danenicol/PALMS/README.md

5e3fbf1b-5832-4e8d-8d21-c7ad76bd68b0 (2)

# PALMS
Passive Analog Localization via Multilateration System 被动式模拟多点定位系统

Designed by: Dane Nicol @SDSUMechatronics

## General Summary (English)
PALMS is a fully analog system that detects underwater acoustic pingers at five specific frequencies (20–40 kHz) and provides directional guidance for autonomous underwater vehicles (AUVs). At its core is a state variable filter (SVF) that enables precise, independent control of frequency and selectivity without any digital signal processing. The system prioritizes low latency, deterministic timing, and minimal digital control, making it ideal for real-time navigation in high-noise aquatic environments. This project is for SDSU Mechatronics' participation in Robo-Sub, from Robo-Nation: https://robosub.org/

## 总结（简体中文）
PALMS是一个全模拟系统，用于检测五个特定频率（20–40 kHz）的水下声学脉冲信号，并为自主水下航行器（AUV）提供方向引导。其核心是状态变量滤波器（SVF），无需任何数字信号处理即可独立控制频率和选择性。该系统以低延迟、确定性定时和最少的数字控制为优势，非常适合高噪声水下环境中的实时导航。 这项目为了SDSU Mechatronics’ 参加在Robo-Sub，从Robo-Nation: https://robosub.org/

## System Design || Theory || Simulation Results:
[Click here to view the full Documentation](<Documentation/PALMS System Design.pdf>)

## PCB Design
Iteration #2



Iteration #1
*Due to time constrains, design has been simplified to 2 dimensions, with TDOA signals being sent out to another computer. Analog TDOA computation circuit not included within Iteration #1
Screenshot_select-area_20260617214514
Screenshot_select-area_20260617214440

Older Design (Decommissioned)
Screenshot_select-area_20260927210900
Screenshot_select-area_20260927211105

## Application/Results in AUV
COMING SOON
