danenicol/PALMS/Documentation/PALMS System Design.pdf

# PALMS System Design

### Dane Nicol

Designed by Dane Nicol
@Mechatronics SDSU
March 3, 2026

## Block 1 (Voltage Buffer + SVF):

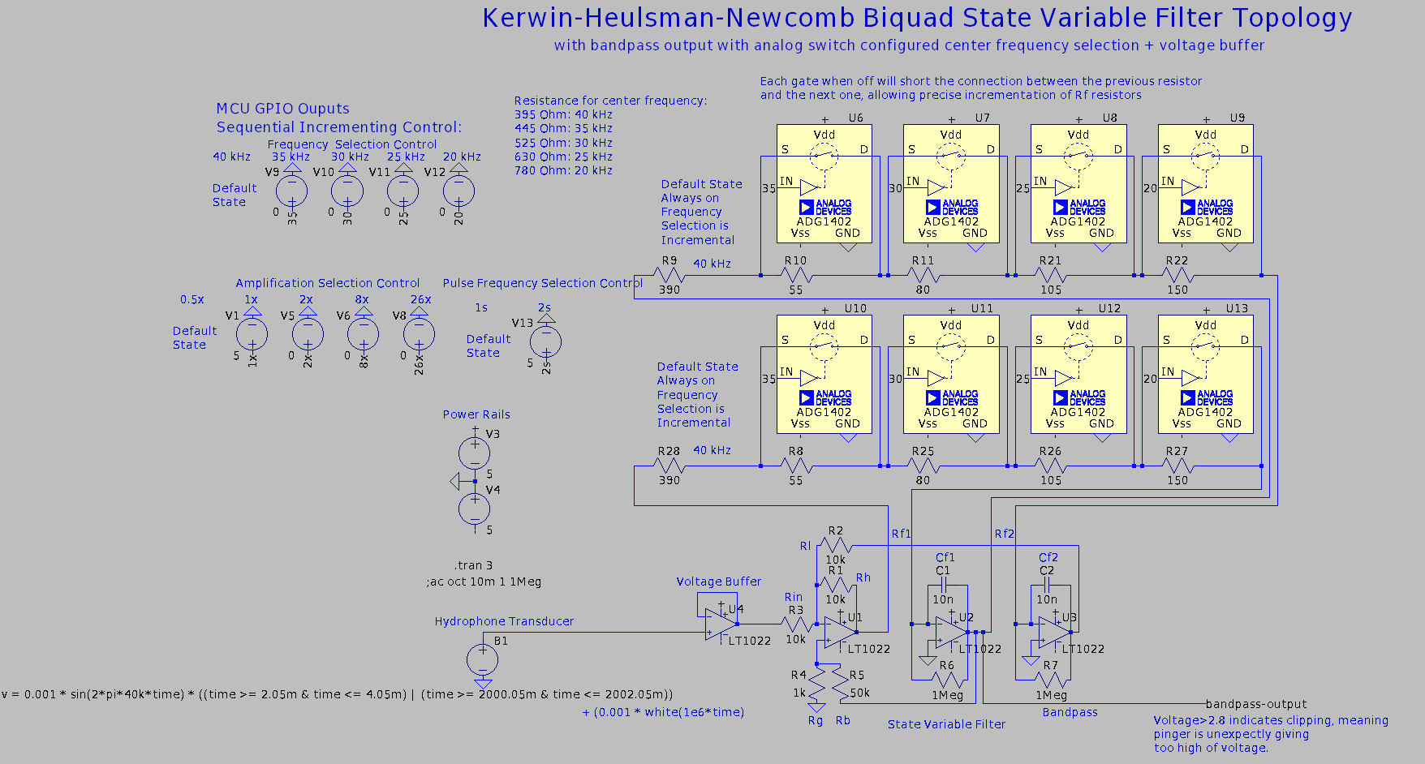
[picture p1: figure]

## Input Buffer Stage:

The hydrophone output is first routed into a voltage buffer. This state isolates the transducer from downstream loading effects, ensuring the best signal integrity and preserving amplitude fidelity. This uses the LT1022, with -/+ 5 V rails. Bandpass output is already low-impedance, no additional buffer needed.

Dane Nicol @SDSUMechantronics

## Analog Tunable State Variable Filter (SVF):

The buffered signal then feeds into the SVF, which is controlled via analog switches, that when off, short the series line of the resistors, bypassing what would be added resistance (that would decrease the selected frequency). The exact resistance was manually tested through many AC sweeps to determine that 395 Ω, 445 Ω, 525 Ω, 630 Ω, and 780 Ω all match the following frequencies 40 kHz, 35 kHz, 30 kHz, 25 kHz, and 20 kHz, respectively:

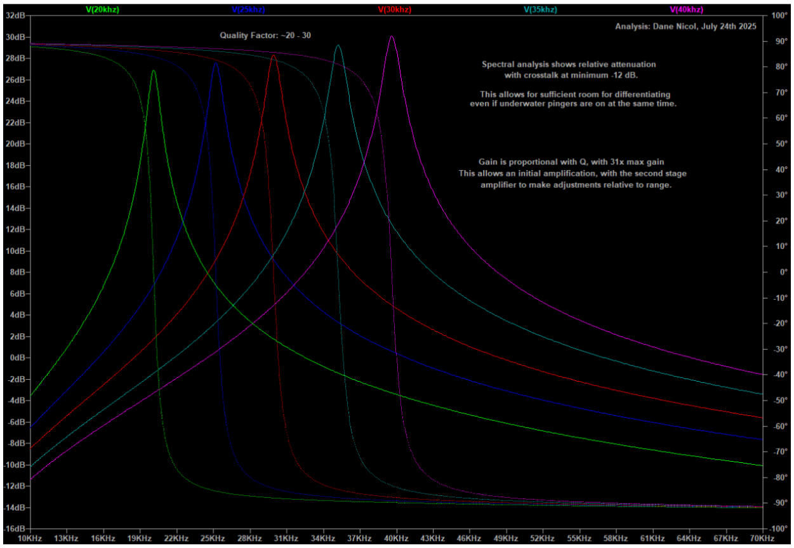
[picture p2: figure]

For the AC signal path, only bandpass behavior is required. However for full analysis of the state variable filter, the following AC sweep provides results for highpass, bandpass, and lowpass behavior:

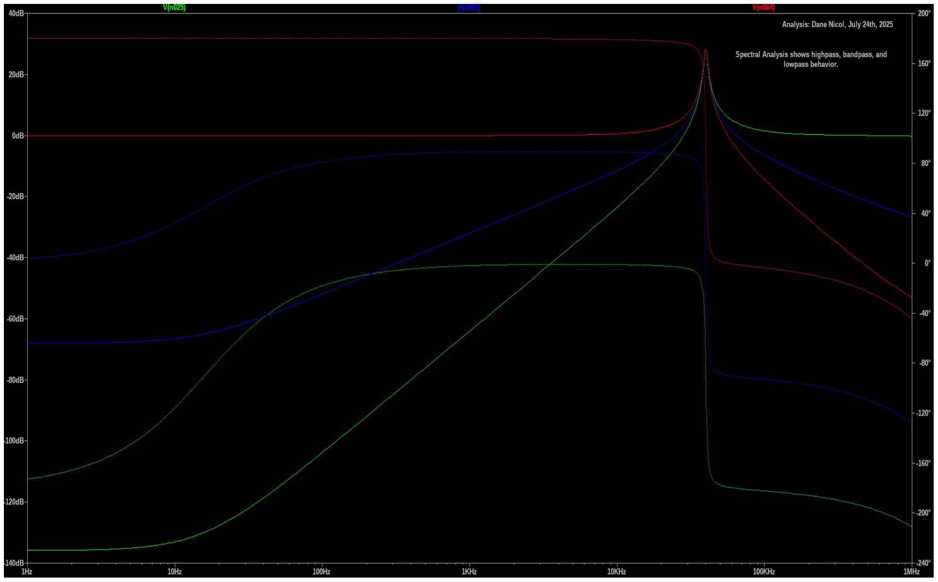
[picture p3: figure]

## Technical Analysis of SVF behavior:

This next section will focus on the transfer functions, and the derived behaviors of the transfer functions. All formulas will be specified and derived before complete analysis of the following frequencies: 20 kHz, 25 kHz, 30 kHz, 35 kHz, and 40 kHz.

The standard state variable filter implements the following three transfer functions in parallel:

Low-pass (LPF): H
LP

(s) =

ω0

2

s

2 + (ω0
/Q) * s + ω0

2

Band-pass (BPF): H
BP

(s) =

(s * ω0

)(1/Q)

s

2 + (ω0
/Q) * s + ω0

2

High-pass (HPF): H
HP

(s) =

s

2

s

2 + (ω0
/Q) * s + ω0

2

The bandpass transfer function is the focus for this analysis, since it is the only one going to be used.

Bandpass transfer function:

H
BP

(s) =

(s * ω0

)(1/Q)

s

2 + (ω0
/Q) * s + ω0

2
Parameters:
- s → Complex frequency domain variable: s = σ + jω
- ω → Natural (center) angular frequency
0
- Q → Quality factor (selectivity)

However, for our specified topology (Kerwin-Heulsman-Newcomb topology), the reciprocal of the quality factor is omitted. So the transfer function for the bandpass becomes:

H
BP

(s) =

ω0

s

s

2 + (ω0
/Q) * s + ω0

2

Before deriving each behavior, finding the angular frequency, quality factor, and bandwidth will be necessary:

Resonance Parameters:
Angular frequency:
ω0 = f
0

* 2π
- Both frequency and angular frequency are resonant Quality Factor:

Q =

ω0

∆ω
- ∆ω: -3 dB bandwidth from resonant peak Bandwidth:

BW =

ω0

Q

Magnitude Response:

Substitute s = jω (Note: j )

2 =− 1

H
BP

(jω) =

ω0

jω

j

2ω

2 + (ω0
/Q) * jω + ω0

2 =

ω0

jω

−ω

2 + (ω0
/Q) * jω + ω0

2 =

jω0ω

(ω0

2 − ω

2
)+ j(ω0ω/Q)
Let β = (normalized frequency): ω
ω0

H
BP

(jω) =

jβ
1−β

2+j(β/Q)
Magnitude:
M(ω)| = |H(jω)| =

|β|

(1−β

2
)

2+(
β
Q

)

2
Reverting to explicit angular frequency terms from β:

M(ω)| =

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
Example:
- Resonant frequency: ω | ( 0 = 1000 rad/s f
0 = 159 Hz)
- Input frequency: ω = 800 rad/s (f
| 0 = 127 Hz)
- Quality Factor: Q = 5
- β =

800
1000 = 0. 8
Plugging values in:
M(ω)| =

|0.8|

(1−0.8

2
)

2+(
0.8
5

)

2 = 2. 03x

Magnitude gain with initial values is 2.03, so at 159 Hz resonant frequency, 127 Hz is amplified by 2.03 times.

Gain Factor:
At resonance s = jω , the gain is:
0

|H
BP

(jω0

)| = |

ω0

(jω0

)

−ω0

2 + j(ω0

2
/Q) + ω0
2 | = |

jω0

2

jω0

2
/Q
| | = Q

Peak gain ∝ Q. This proportional correlation between gain and quality factor is not present in the standard textbook form, where it would instead be (peak gain = 1).

Poles:
The poles are the roots of the denominator:

s

2
+

ω0

Q

s + ω0

2 = 0

(has two poles, since degree = roots) Using the quadratic formula:

ax

2
+ bx + c = 0

x =

−b± b

2−4ac
2a
Solving:

s =

−(ω0

/Q) ± (ω0

/Q)

2 − 4ω0

2
2 | =

−ω0
2Q ± ω0

* (

1
2Q

)

2 − 1

Let ζ = damping ratio:

ζ =

1
2Q
Then:

s =− ζω0 ± ω0

(ζ

2 − 1

Underdamped: Q > 0. 5 → ζ < 1
- Square root is imaginary → complex conjugate pools will result:
- s =− ζω0 ± jω0
(1 − ζ

2

- Impulse response looks like:
- ℎ(t) = e

−ζω0

t
* sin((ω0

1 − ζ

2
)(t))
- Slow decay with strong oscillatory response Example: ω0 = 1000, Q = 5, ζ =

1
2Q = 0. 1
s =− 100 ± j994. 987 → rings at ~955 rad/s

Critically damped: Q = 0. 5 → ζ = 1
- Square root is zero → repeated real pole:
- s =− ω (double root)
0
- Impulse response looks like:
- ℎ(t) = te

−ω0

t
- Fastest possible decay with non-oscillatory response Example: ω0 = 1000, Q = 0. 5, ζ = 1

s =− 1000 (twice)

Overdamped: Q < 0. 5 → ζ > 1
- Square root is real → two distinct real poles:
- s =− ζω0 ± ω0
ζ

2 − 1

- Both poles are going to be negative → sum of two decaying exponentials
- No oscillation, slower than critically damped
Example: ω0 = 1000, Q = 0. 2, ζ =

1
2Q = 2. 5

s =− 2500 ± j2291. 288
s

1 = ~ − 219

s

2 = ~ − 4781

Stability:
Since all the poles have negative real parts for Q > 0 → system remains stable However:
- If real part < 0 → system is stable
- If real part = 0 → system is marginally stable (sustained oscillations)
- If real part > 0 → system is unstable (output grows without bound)
This section for clarity will be under poles, BIBO stability section is specified under system properties.

Impulse response:
To find the impulse response specific to our topology, we can assume that the impulse response h(t) is the inverse Laplace transform of the transfer:

H
BP

(s) =

ω0

s

s

2 + (ω0
/Q) * s + ω0

2

The impulse response can be found via:

ℎ
HP

(t) = ℒ

−1
{H
BP

(s)}
(Assuming a casual LTI)

The denominator: s

2
+

ω0

Q

s + ω0

2

Completing the square so it appears as: (s + a) , since it has known inverse ² + β

2
laplace transforms.
Grouping: s

2
+

ω0

Q

s + ω0

2 = (s

2
+

ω0

Q

s) + ω0

2

Completing the square on the quadratic in s: s

2
+

ω0

Q

s = (s +

ω0

2Q

)

2 − (

ω0

2Q

)

2

Therefore: (s

2
+

ω0

Q

s) + ω0

2 = (s +

ω0

2Q

)

2 − (

ω0

2Q

)

2
+ ω0

2

Combining constants: − (

ω0

2Q

)

2
+ ω0

2 = ω0

2
(1 −

1
4Q

2 )
Defining:
- a =

ω0

2Q

- β = ω0
1 −

1
4Q

2
Denominator is now: s

2
+

ω0

Q

s + ω0

2 = (s + a)

2 − β

2

Transfer function is now: H
BP

(s) =

ω0

s

(s+a)

2+β

2

Now the numerator needs to be reshaped to fit for the laplace pairs: Damped cosine: ℒ

−1
{

s+a
(s+a)

2+ωd

2 } = e

−at
cos(βt)

Damped sine: ℒ

−1
{

β
(s+a)

2+β

2 } = e

−at
sin(βt)

Rewriting s in terms: s = (s + a) − a

H
BP
(s) = | → Distribute | →

ω0

((s+a)−a)

(s+a)

2+β

2 | ω0

ω0

(s+a)−ω0

a

(s+a)

2+β

2
Using the basic fraction property: A−B
D =

A
D −

B
D
Where:
- A = ω0
| (s + a)
- B = ω0
a
- D = (s + a)

2
| + β
| 2
Now the transfer function becomes:

ω0

(s+a)

(s+a)

2+β

2 −

ω0

a

(s+a)

2+β

2
Term 1 - Term 2

Term 1 corresponds to the damped cosine laplace pair:

ω0

* ℒ

−1
{

(s+a)
(s+a)

2+β

| 2 } = ω0 e −at cos(βt)

Term 2 relates to the damped sine laplace pair:

ω0

a

(s+a)

2+β

2 =

ω0

a

β

*

| β (s+a) 2+β
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
(s+a)

2+β

| 2 } = ω0 a β e −at
sin(βt)

Put terms back into their initial subtraction:

ω0

e

−at
cos(βt) −

ω0

a

β

| e −at sin(βt)

Since the system is casual add u(t) and make exponential external:

ℎ
BP

(t) = e

−at
[ω0
| cos(βt) − ω0 a β
sin(βt)] u(t)

Our final impulse response:

ℎ
BP

(t) = e

−at
[ω0

cos(βt) −

ω0

a

β

sin(βt)] u(t)

Solving an example: ω0 = 1000, Q = 5 First compute a and β:

- a = →

ω0

2Q

1000
2*5 = 100 s

−1

- β = ω0

1 − →

1
4Q

2 1000 1 −

1
4(5)

2 = 994. 99 rad/s = ~955 rad/s Plugging values in:

ℎ
BP

(t) = e

−100t
[1000cos(995t) − 100. 5sin(995t)] u(t) At the given example values:
- Initial velocity: 1000, system is sensitive by sharp transients, instant, hard response, system also sensitive to high-frequency components.
- Envelope: e . Oscillations decay with time constant 1/100 = 0.01 s. Rings for ⁻¹⁰⁰t a short time. If Q increased, decay would be slower, vise versa.
- Oscillation frequency: ~995 rad/s. Frequency system rings at after impulse, slightly lower than resonant angular frequency ω because the higher quality
0
factor creates moderate damping.

Phase Response:
To find phase response, substitute the transfer function with s = jω. However we already did this for the magnitude response, hence:

H
BP

(s) =

ω0

s

s

2+

ω0

Q

s+ω0

2
Substituting (s = jω):

H
BP

(s) =

jω0ω

(ω0

2 − ω

2
) + j

ω0

Q
This complex number can be represented as a vector in the complex plane, via:

ϕ(ω) = ∠H
BP

(jω) = tan

−1
(

Imaginary Part
Real Part

)
Since both numerator and denominator are both complex, total phase:
ϕ(ω) = ∠(numerator) − ∠(denominator)
- Numerator is completely imaginary so → +90°
- Denominator has both real && imaginary → depends on angular frequency

Total phase:

ϕ(ω) = 90° − tan

−1
(

ω0
Q ω

ω0

2 − ω

2 )

- At ω = ω (resonant frequency), the phase shift is 0°, meaning the output signal
0
is in phase with the input signal.
- At ω → 0 (below resonant frequency), the output leads the input by +90°
- At ω → ∞ (above resonant frequency), the output lags the input by -90°

Solving an example: (ω0 = 1000, ω = 800, Q = 5)

ϕ(ω) = 90° − tan

−1
(

1000/5 800

1000

2 −800

2 ) = 66. 04°
Output leads the input by 66 degrees.

Group Delay:
Solving for group delay is the negative derivative of the phase response with respect to frequency:
τ
g

(ω) =−

dϕ(ω)
dω
Using the the derived phase response we got before:

ϕ(ω) = 90° − tan

−1
(

ω0
Q ω

ω0

2 − ω

2 )

Group delay is derived by differentiating the above expression:

d
dω

[tan

−1
(u)] =

1
1 + u

2 *

du
dω
Where u = | , computing provides the final group delay:

ω0
Q ω

ω0

2 − ω

2

τ | , showing peak delay when
g

(ω) =

ω0

Q

(ω0

2 + ω

2
)

(ω0

2 − ω

2
)

2 + (

ω0
Q ω)
2 | ω ≠ ω0

At ω = ω , this expression simplifies to:
0
τ | , showing peak delay at resonance
g

(ω) =

Q
ω0

Solving an example: At ω = ω0

With: ω0 = 1000, Q = 5

τ | (Envelope rises to peak with time constant of 5 ms from
g

(ω) =

| Q ω0 →
| 5 1000 = 5 ms

bust sine wave)

Solving an example: At ω ≠ ω0

With: ω0 = 1000, ω0 = 800, Q = 5

τ | (Envelope rises to peak with time constant
g

(ω) =

| 1000/5(1000 2 + 800
| 2 ) (1000 2 − 800
| 2 ) 2 + ( 1000/5 800) 2 = ~12. 8 ms

of ~12.8 ms from bust sine wave)

Asymptotic Roll-off:
The idealized rate at which a filter's gain decreases beyond its cutoff frequency: From order under system properties, the system was determined to be second-order. This would automatically insinuate an asymptotic roll-off of -40 dB/decade or -12 dB/octave. However because of the bandpass coming from the first integrator output, roll-off shows behavior of a first-order system, giving:
-20 dB/decade or -12 dB/octave

Dynamic Model Analysis:
Ordinary differential equation (ODE) derivation: Starting from the transfer function:
H BP | (s) = Y(s) X(s) = ω0 s s 2 + ω0 Q s + ω0
| 2
Cross multiplying:

Y(s)(s

| 2 + ω0 Q s + ω0
| 2 ) = X(s) * ω0 s

Applying inverse Laplace transform to each term:

ℒ

−1 | {s
| 2 Y(s)} → d
| 2 y dt
| 2
ℒ
−1 | {sY(s)} → dy dt

ℒ

−1 | {Y(s)} → y(t)

ℒ

−1 | {sX(s)} → dx dt
This provides the differential expression:

d

2
y
dt
2 | + ω0 Q * dy dt + ω0
| 2 y = ω0 * dx dt

This expression shows how the output y(t) evolves over time in response to changes in the input x(t).

Reverting back to transfer function:
Starting from the ODE:

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
dt + ω0

2
y = ω0

*

dx
dt
Applying Laplace transform to each term:

ℒ{

d

2
y
dt

2 } → s

2
Y(s)

ℒ{

dy
dt

} → sY(s)
ℒ{y(t)} → Y(s)
ℒ{

dx
dt

} → sX(s)
This provides the s-domain expression:

Y(s)(s

2
+

ω0

Q

s + ω0

2
) = X(s) * ω0

s
Factoring Y(s) and solving for H(s) = :

Y(s)
X(s)
H
BP

(s) =

ω0

s

s

2 +

ω0

Q

s + ω0

2
Recovering the original transfer function.

System properties:
Causality:
From transfer function:

H
BP

(s) =

Y(s)
X(s) =

ω0

s

s

2 +

ω0

Q

s + ω0

2
Checking if proper (degree of numerator ≤ degree of denominator)
- Numerator: ω → degree = 1
0

s

- Denominator: s | → degree = 2

2
+

ω0

Q

s + ω0

2

This indicates a proper function, meaning it is causal. (Would be improper if numerator degree > denominator, meaning it would be non-causal).

Checking poles (transfer function → ∞) and zeros (transfer function = 0):
Zeros (What values of s make the numerator zero?):
- s = 0 → ω0
s = 0
There is 1 zero.

Poles (What values of s make the denominator zero?):
- Poles = roots of denominator polynomial
- Polynomial of degree n has exactly n roots (real or complex)
Since we determined from the transfer function that the denominator has degree 2, it can be assumed that there are 2 poles.

This indicates a causally, because:
Number of finite zeros ≤ Number of finite poles
In our case 1 zero ≤ 2 poles.

From differential equation:

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
dt + ω0

2
y = ω0

*

dx
dt
This automatically shows a causal system because:
- Right-hand side (input): ω → depends on the current rate of change of input.
0

dx
dt
- No future values of x(t) are needed, only present and past values.

Memory:
- A system has memory if its output depends on past (or future) inputs.
- A system is memoryless if output depends only on the current input.

From transfer function:

H
BP

(s) =

ω0

s

s

2 +

ω0

Q

s + ω0

2
- If the transfer function does not have poles or zeros (just a constant) than it is memoryless.
- If the transfer function has any poles or zeros, it has memory.
We just checked previously if the system had zeros or poles (which it does), so it can be assumed the system has memory from its transfer function.

From differential equation:

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
dt + ω0

2
y = ω0

*

dx
dt
- Left side contains derivatives of y(t) → system state depends on past behavior.
- Right side has dx/dt → response depends on how input is changing, not just current value
Automatically can be inferred from the ODE that the system has memory.

BIBO stability:
The system is BIBO (bounded-input bounded-output) stable if every bounded input produces a bounded output.

For LTI systems, BIBO stability holds only if the impulse response is absolutely integrable:
- Must decay fast enough over time (has exponential decay such as e ). ⁻at
- Cannot grow with time/does not decay (constant or oscillatory without decay).
- Slow decay still can diverge making it non-integratible.
For our impulse response:

ℎ
BP

(t) = e

−at
[ω0

cos(βt) −

ω0

a

β

sin(βt)] u(t)
Exponential decay shows that it is integratable, hence the system is BIBO stable.

In the s-domain: all poles must lie in the open left half-plane (negative real parts). Already solved in stability under poles.

Linearity:
This can already be assumed based on the transfer function being an LTI, however from the ODE we can figure out if it satisfies superposition:
- Additivity: y(x
1 + x
2

) = y(x
1

) + y(x
2

)
- Homogeneity: y * (cx) = cy(x)
- Combined, they form superposition: y(c
1

x

1 + c
2

x
2

) = c
1

y(x
1

) + c
2

y(x
2

)

Our ODE:

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
dt + ω0

2
y = ω0

*

dx
dt
- All terms involving y(t) and x(t), and their derivatives are linear (no y ). ² , y

dy
dt
- Zero initial conditions make it linear (non-zero initial conditions would make it non-linear).
- The differential operator on the left is linear → satisfies both additivity and homogeneity.

The system is linear.

Order:
The order of a continuous-time LTI system is the order of the differential equation describing it, or equivalently, the degree of the denominator polynomial in the transfer function.

From transfer function:

H
BP

(s) =

ω0

s

s

2 +

ω0

Q

s + ω0

2
Degree of denominator = 2
Therefore it is a second-order system.

From differential equation:

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
dt + ω0

2
y = ω0

*

dx
dt
Second derivative = 2
Therefore it is a second-order system.

Note: because of the topology of state variable filters, the bandpass output is taken from the first integrator stage, however a single integrator acts as a first order circuit on its own. Despite this, the BP signal is still part of a second-order feedback loop (it’s fed back to influence the input, creating the full second-order dynamics).

Time Invariance:
From differential equation:

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
dt + ω0

2
y = ω0

*

dx
dt
The system only has constant coefficients (no terms involving t, t^2, or e^t). Note: derivative terms do not affect the time invariance, coefficients of the ODE are still not functions of time. Therefore it is time invariant.

Simulation Full Analysis:
(at 40 kHz resonance)

Transient Analysis:

Group delay shows appropriate delay, damping shows underdamped behavior, gain factor is proportional to Q. All calculations consistent with transient analysis.

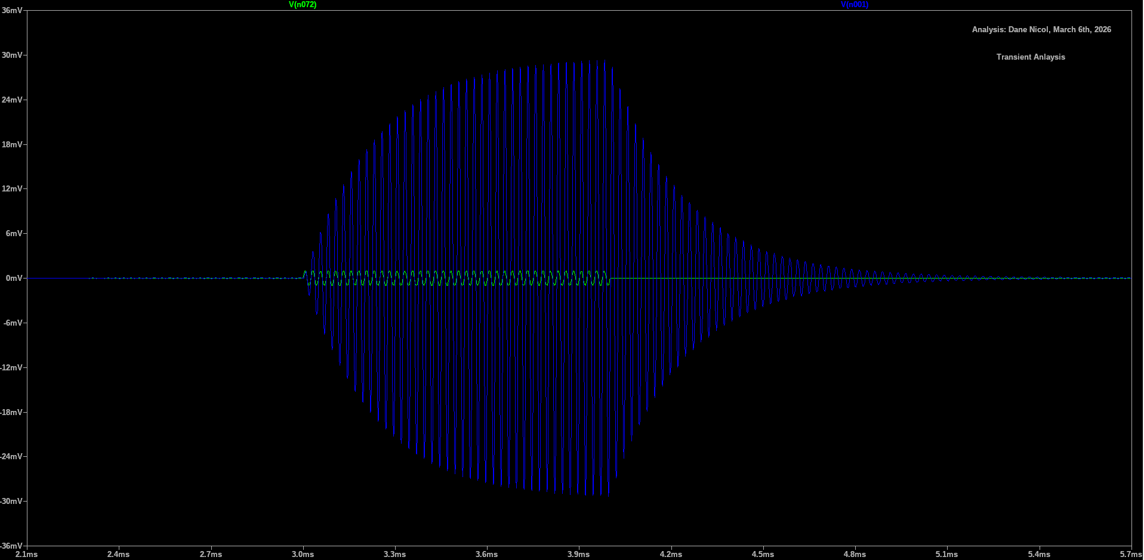
[picture p4: figure]

Spectral Analysis:
Bandwidth, phase response, quality factor, and peak all consistent with previous calculations.

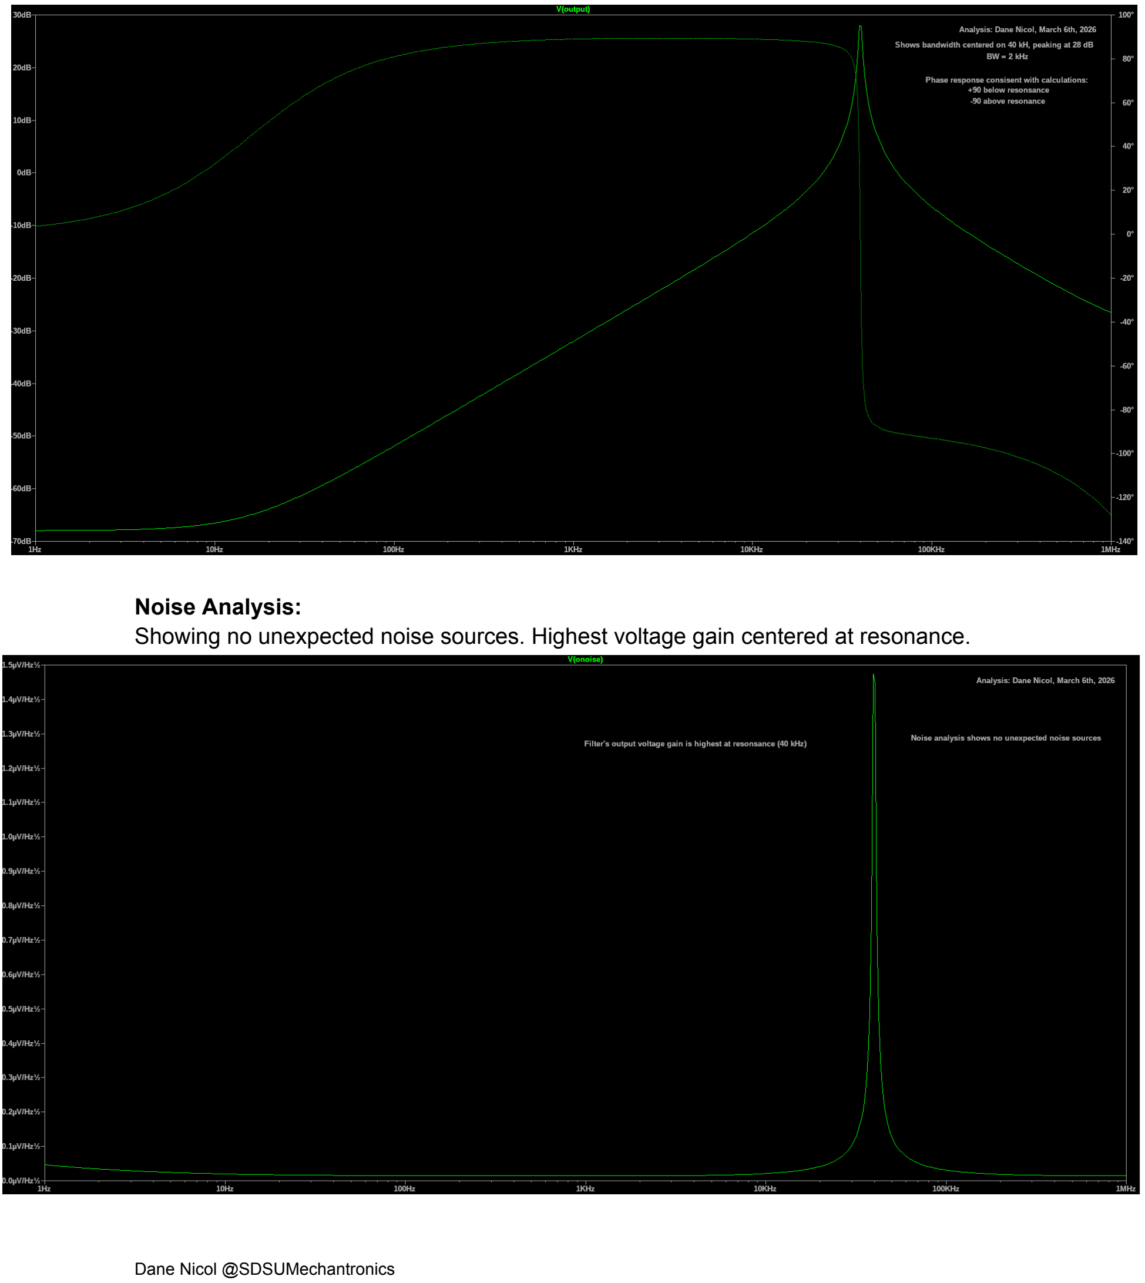
[picture p5: page 17]

Noise Analysis:
Showing no unexpected noise sources. Highest voltage gain centered at resonance.

Fourier Analysis:
Fast fourier transform graph (FFT):

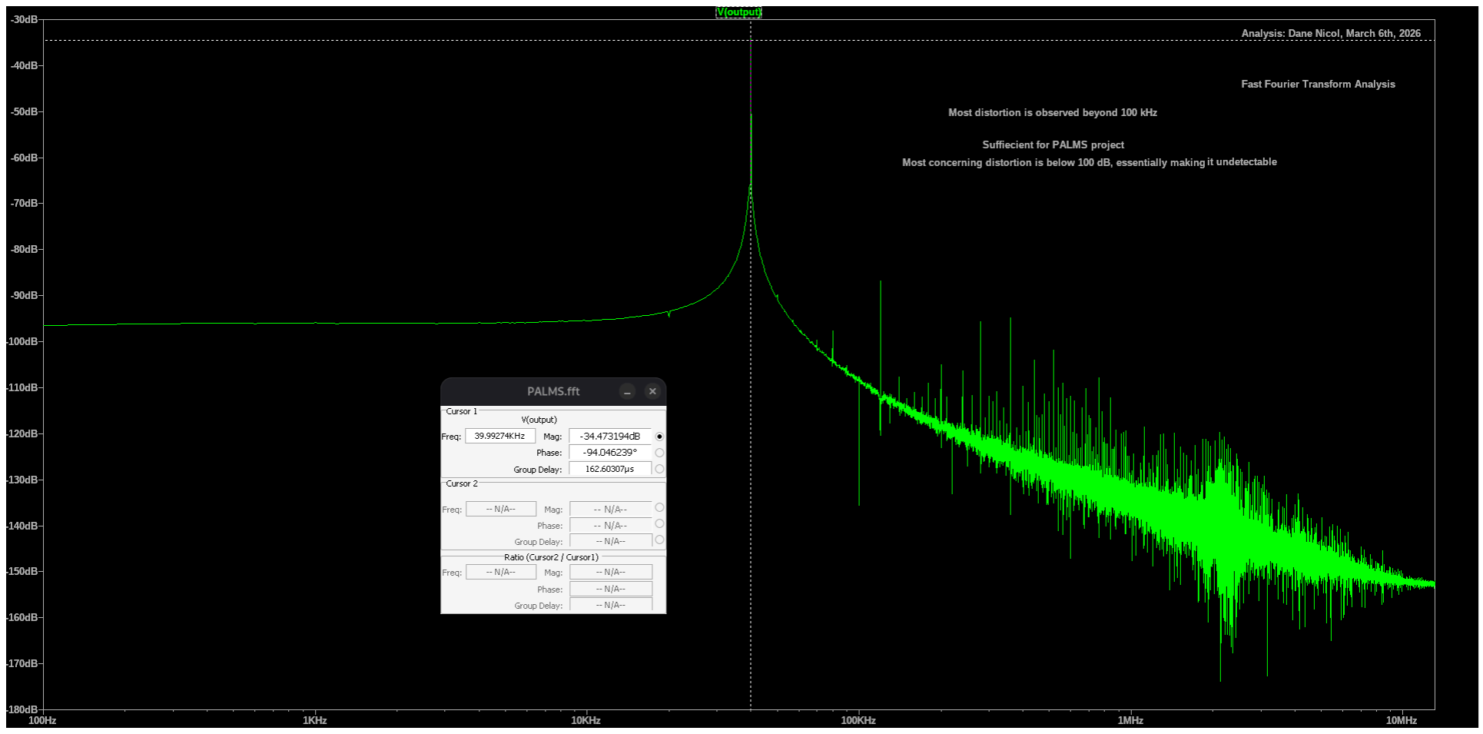
[picture p6: figure]

Error log (for harmonic data): N-Period=1
Fourier components of V(output)
DC component:2.49711e-006
Harmonic | Frequency | Fourier | Normalized Phase | Normalized
Number | [Hz] | Component Component [degree] | Phase [deg]
1 | 4.000e+04 2.941e-02 | 1.000e+00 | -16.96° | 0.00°
2 | 8.000e+04 1.468e-05 | 4.993e-04 | -163.84° | -146.88°
3 | 1.200e+05 4.899e-05 | 1.666e-03 | 43.00° | 59.96°
4 | 1.600e+05 1.237e-05 | 4.206e-04 | -44.25° | -27.29°
5 | 2.000e+05 7.653e-06 | 2.602e-04 | -147.10° | -130.13°
6 | 2.400e+05 8.780e-06 | 2.986e-04 | -92.69° | -75.73°
7 | 2.800e+05 1.771e-05 | 6.023e-04 | 147.07° | 164.03°
8 | 3.200e+05 4.008e-06 | 1.363e-04 | 139.53° | 156.50°
9 | 3.600e+05 2.202e-05 | 7.486e-04 | 70.35° | 87.31°
Total Harmonic Distortion: 0.207372%(0.223797%)
Date: Fri Mar 06 14:48:46 2026
Total elapsed time: 27.635 seconds.

Interpretation:
Very low and indicates excellent signal purity.
Below 0.1%: Generally inaudible, considered high fidelity.
0.1% – 1%: Good to acceptable; 0.2% is well within this range and typically not perceptible in most applications.

## Block 2 (Manual Amplifier):

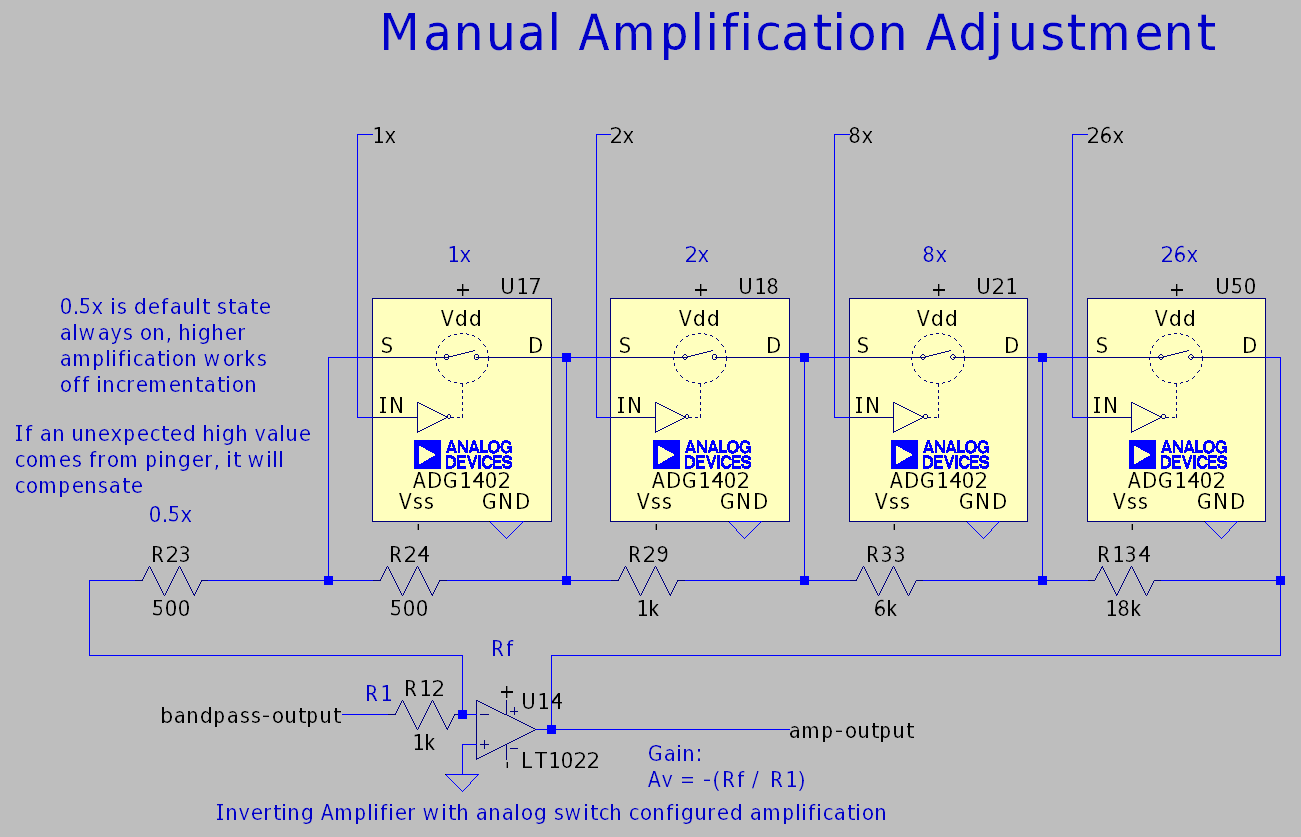
[picture p7: figure]

The following circuit is the manual amplifier, a simple inverting amplifier with the same analog switch configuration the SVF had. The ideal state should leave amplification at 1x, unless the situation requires (2x, 8x, 26x) (weaker signal/longer range), or 0.5x (overamplification via SVF, requires reduction to prevent wave clipping if signal is stronger than assumed).

The following analysis shows an example of a 1 mV, 40 kHz waveform (while SVF has its center frequency at 40 kHz), being amplified by the SVF to 30 mV, then proceeding to get manually amplified 10x to 300 mV:

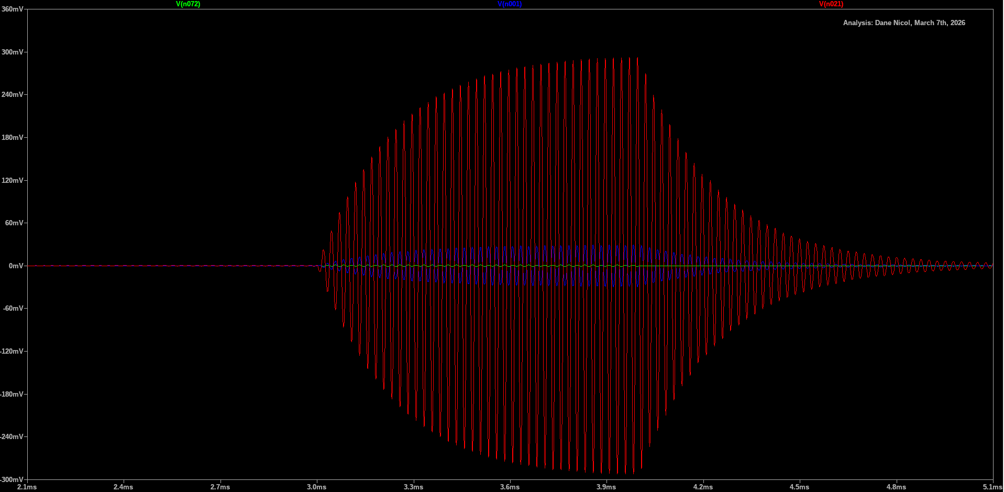
[picture p8: figure]

This amplification stage is less of a necessity and more of a precaution, as pulse detection has a dynamic threshold.

Voltage gain of the inverting amplifier configuration:

G =−

R
f
R
1
Worth noting, the output signal of the inverting configuration is 180° out of phase relative to the input signal. This should not affect TDOA.

## Block 3 (Rectifier Stage):

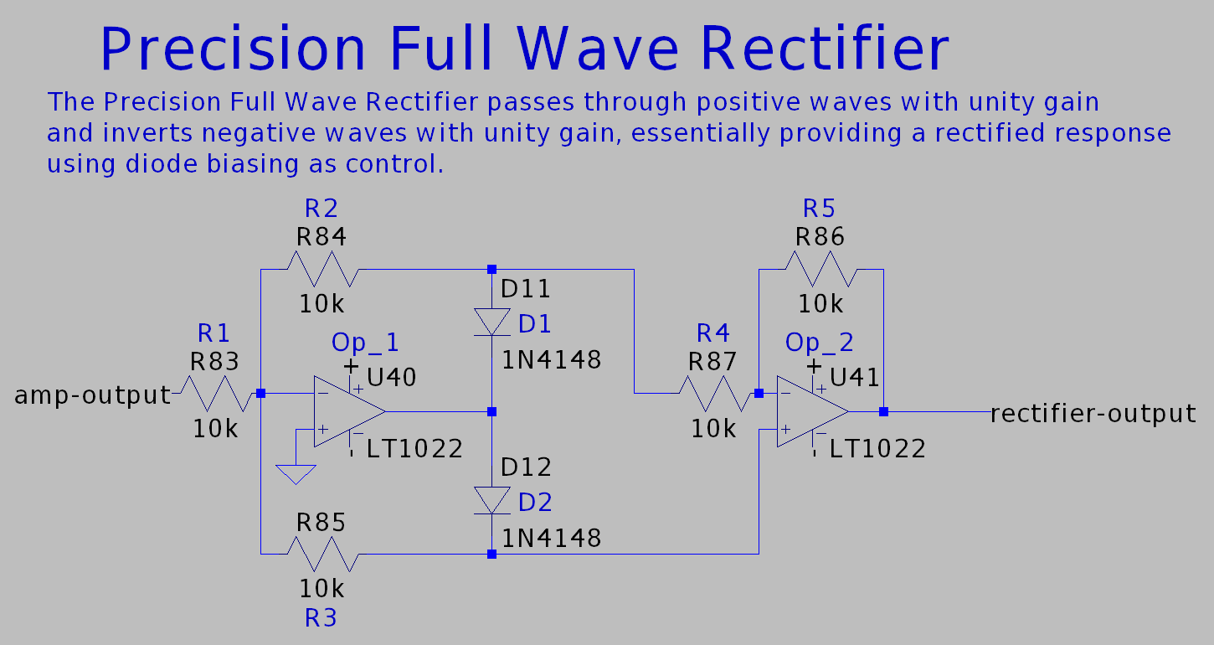
[picture p9: figure]

The next stage is a precision full wave rectifier, for the purpose of removing negative voltages in preparation for amplitude-threshold/delay processing.

This rectifier:
- When V , op amp output goes negative, forward biasing diode 1 and
in > 0
reverse biasing diode 2. This creates an equivalency of two proportional inverting amplifiers connected together in series:
V | (assuming 10k constant for resistors).
out = (−

R2
R1
| ) * (− R5 R4 ) = V in
This allows the positive wave signals to pass through what is essentially an non-inverting amplifier with 1x gain (unity voltage buffer).
- When V , op amp output goes positive, reverse biasing diode 1 and forward
in < 0
biasing diode 2. This creates an equivalency of a singular inverting amplifier with 1x gain, flipping the negative waves positive:
V

out = (−

R5
R4
| )
The following analysis shows a 40 kHz, 300 mV sine wave be rectified:

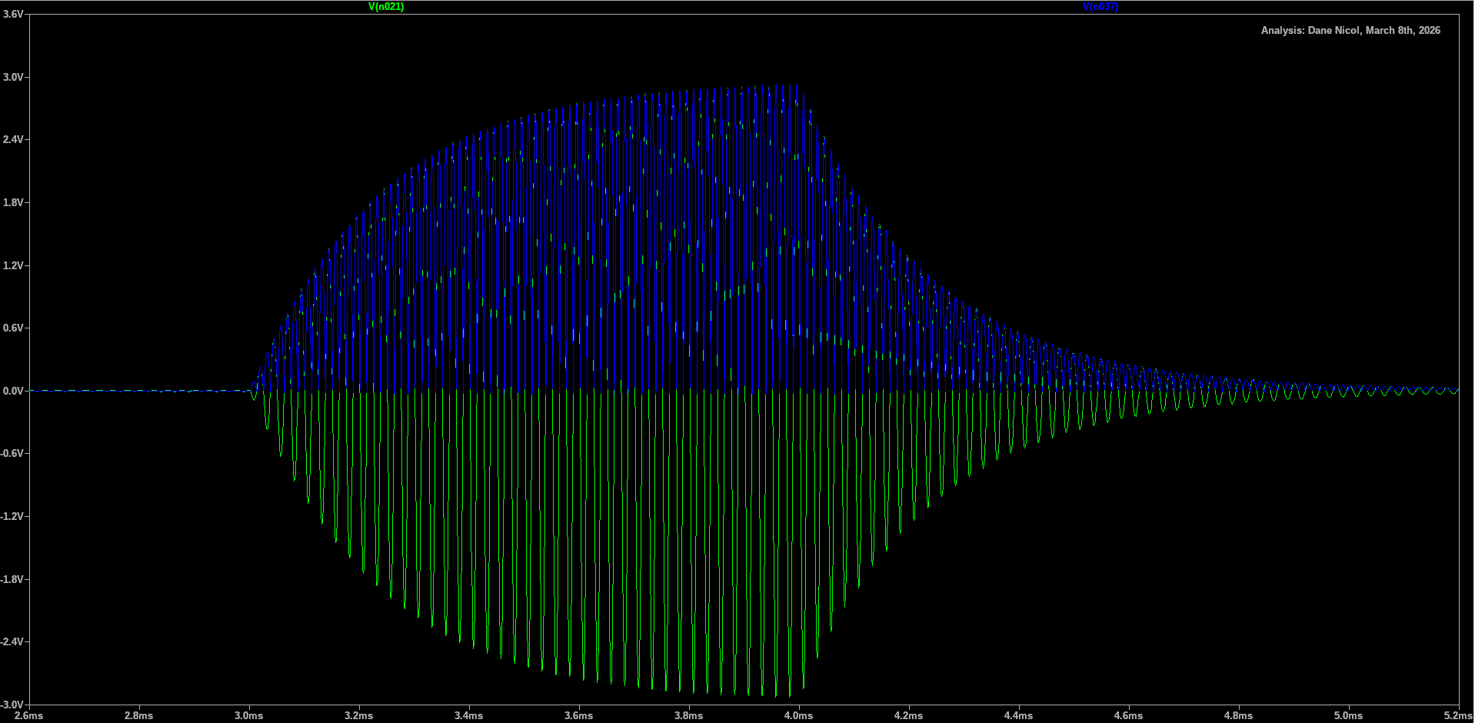
[picture p10: figure]

As shown, negative wave cycles are flipped to positive.

## Block 4 (Amplitude-Threshold/Decay):

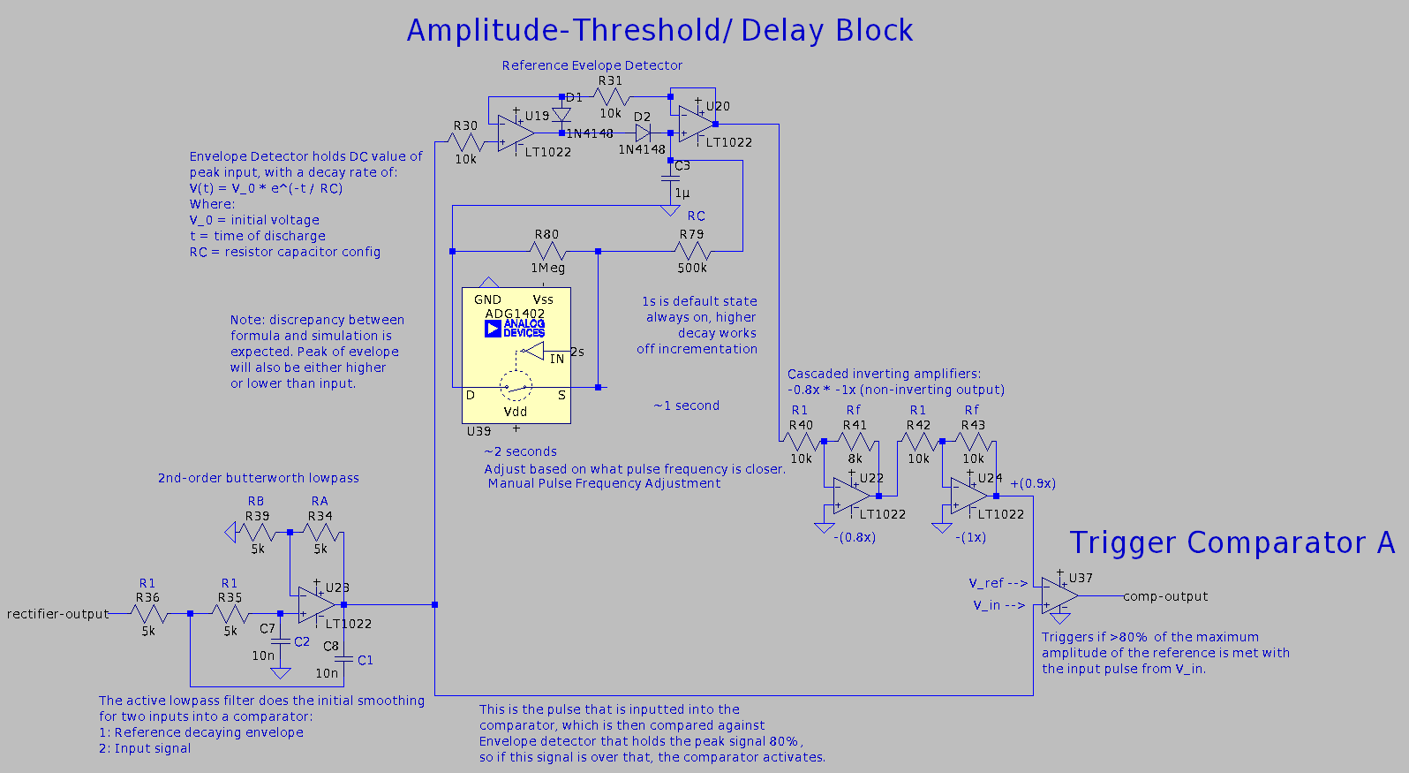
[picture p11: figure]

The same methods that I used before to analyze the transfer function of the bandpass and derive several behaviors from are omitted for sake of redundancy and brevity of this documentation.

Block 4 starts off with a 2nd-order butterworth lowpass filter to properly smooth the high frequency input signal into a pulse, as shown in the following transient:

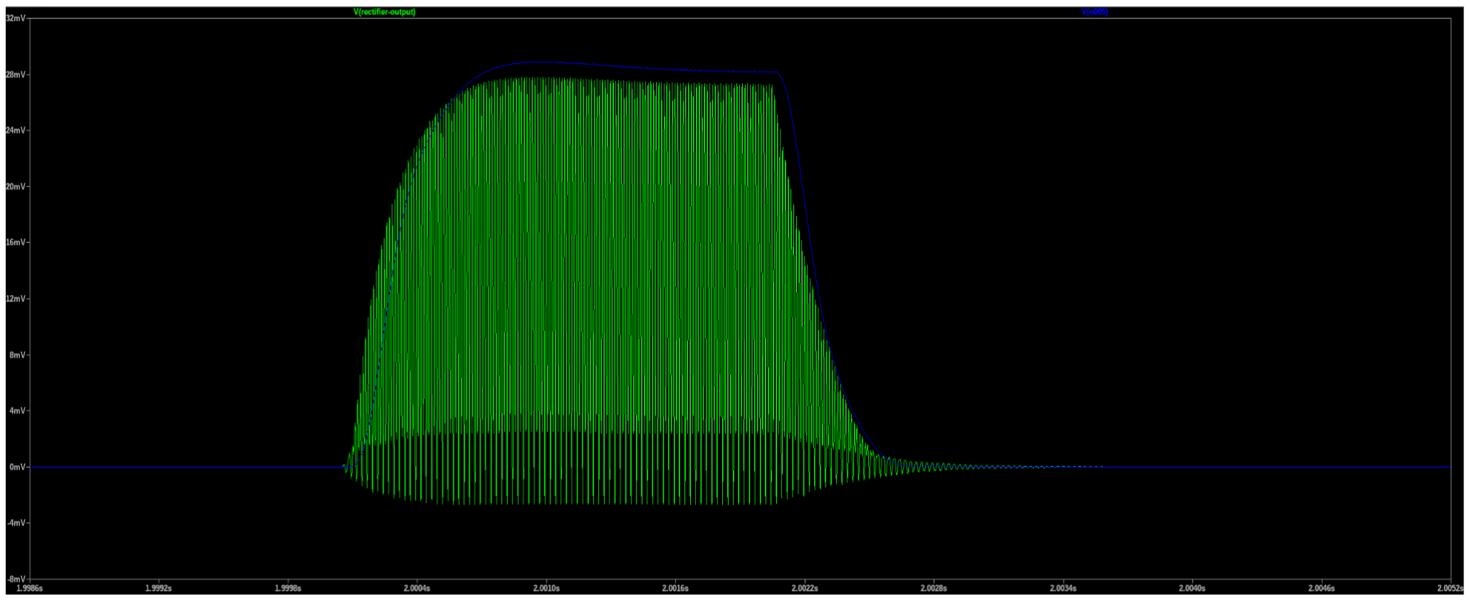
[picture p12: figure]

Without it, it would rapidly oscillate the trigger comparator’s input. As shown in the simulation, there is a slight, negligible delay that does not affect TDOA, as the other input for horizontal or vertical comparison also will have this delay. This should also be considered for all propagation delay present in the circuitry.

Following this smoothed pulse are the two inputs of the trigger comparator, one reference, one input signal. The input signal has the pulse go directly to it. For the reference, the pulse first goes through an envelope detector that holds the peak of the pulse, with a selectable decay (2 or 1 second decay). The following transient shows the behavior of the 2 second:

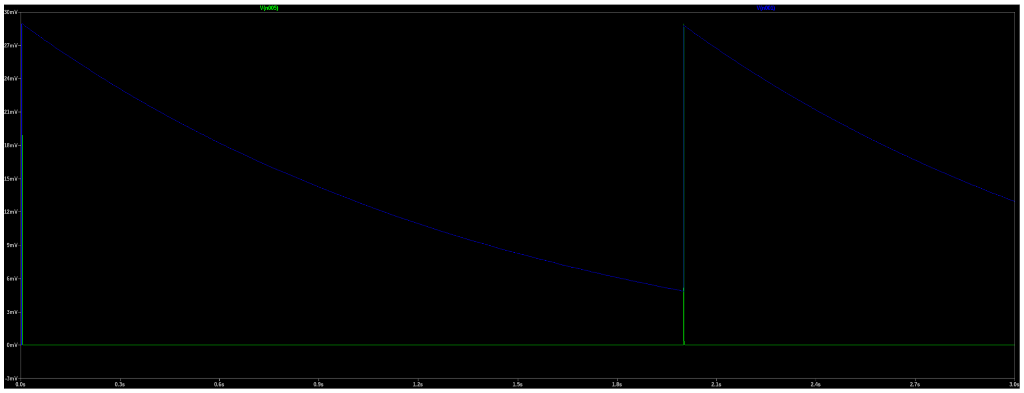
[picture p13: figure]

This provides a lot enough time for the largest magnitude signal of the selected pinger frequency (which should theoretically be the true signal of the pinger, nothing else), and holds it for enough time to be used as a voltage reference for the trigger comparator input signal, while decaying to allow for automatic threshold adjustment in regards to the magnitude.

The following formula solves for the approximate decay rate:

V(t) = V
0

* e

−t/RC

Where:
- V is the initial voltage
0
- t is the time of discharge (so the very ns after the pulse)
- RC the resistor capacitor config

There will however be some non-unsignificant discrepancy between the formula and actual result, so following simulation for exact numbers is necessary.

Before this goes into the trigger comparator reference, there are cascaded inverting amplifiers that I have manually cycled through many variations to find what reduction in amplitude would be ideal to provide sufficient headroom for the input signal to prevent oscillation, since the signal will be “wobbly” under non-ideal conditions.

Now, the following transient shows the ~2.4 second duration of the behavior of the trigger comparator with 2 pulses from the pinger:

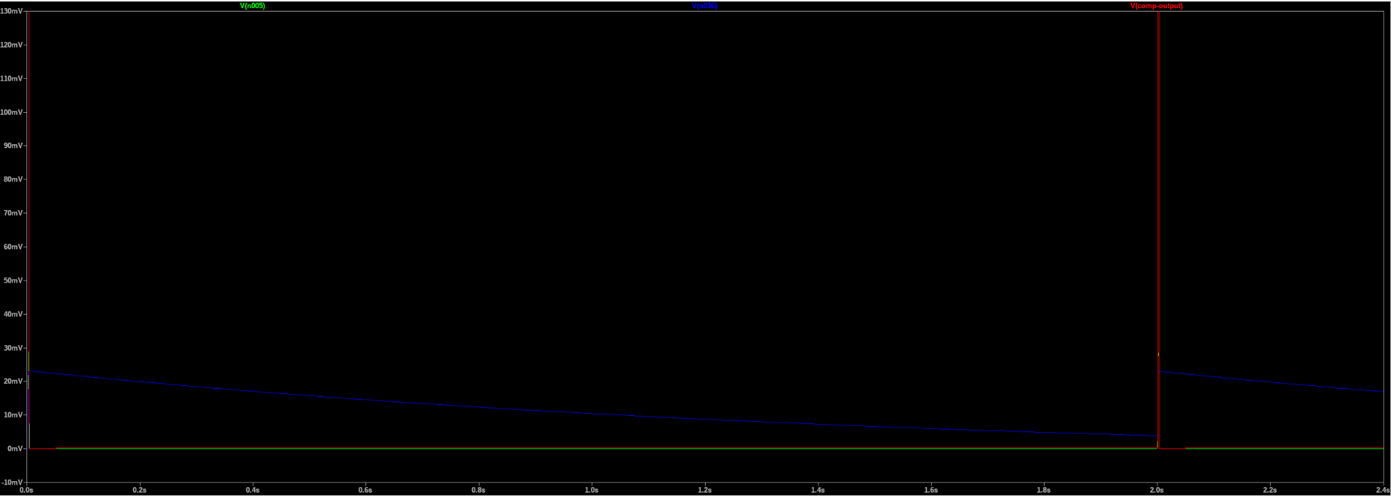
[picture p14: figure]

With no oscillation, the digital output is nearly 1:1 of the pulse of the pinger, finally providing a clean and accurate digital signal ready for TDOA calculations.

For clarification The red signal goes to 5 volts since it is a digital output, but this simulation graph was shortened to show the behavior of the other signals as well.

Another up close transient shows the behavior working perfectly for a clean digital response:

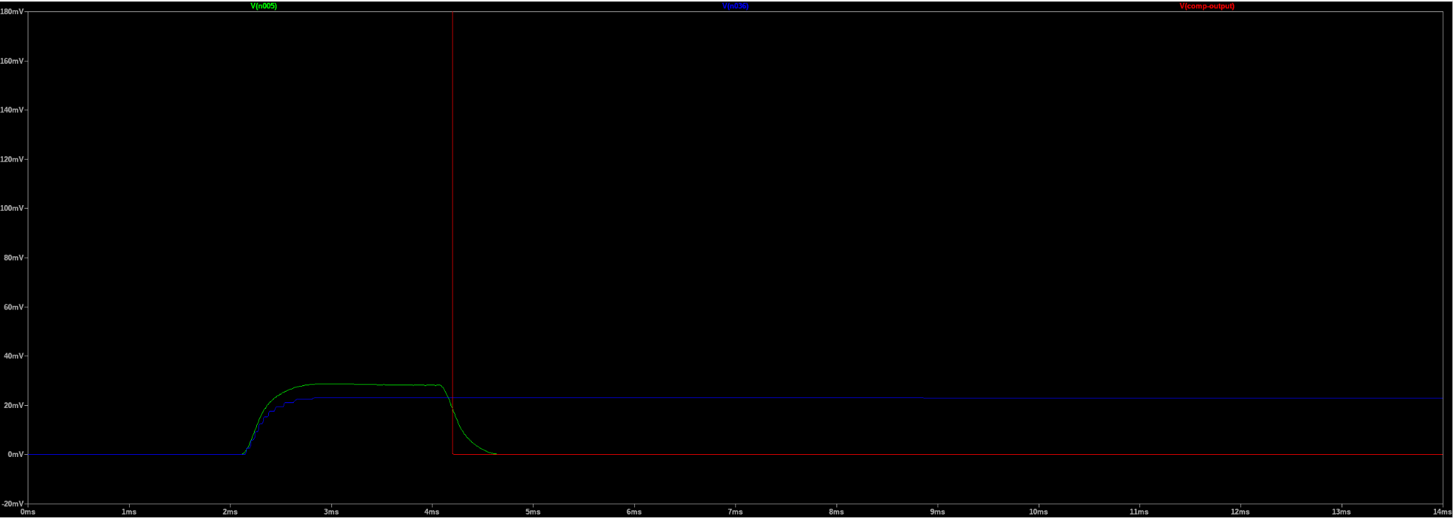
[picture p15: figure]

This is now ready to be input into a microcontroller or computer to calculate the exact angle of a pinger relative to the UAV, for both horizontal and vertical orientations, allowing localization regardless of the depth of the pinger in the water.

## Block 5 (Arming/Disarming Control System):

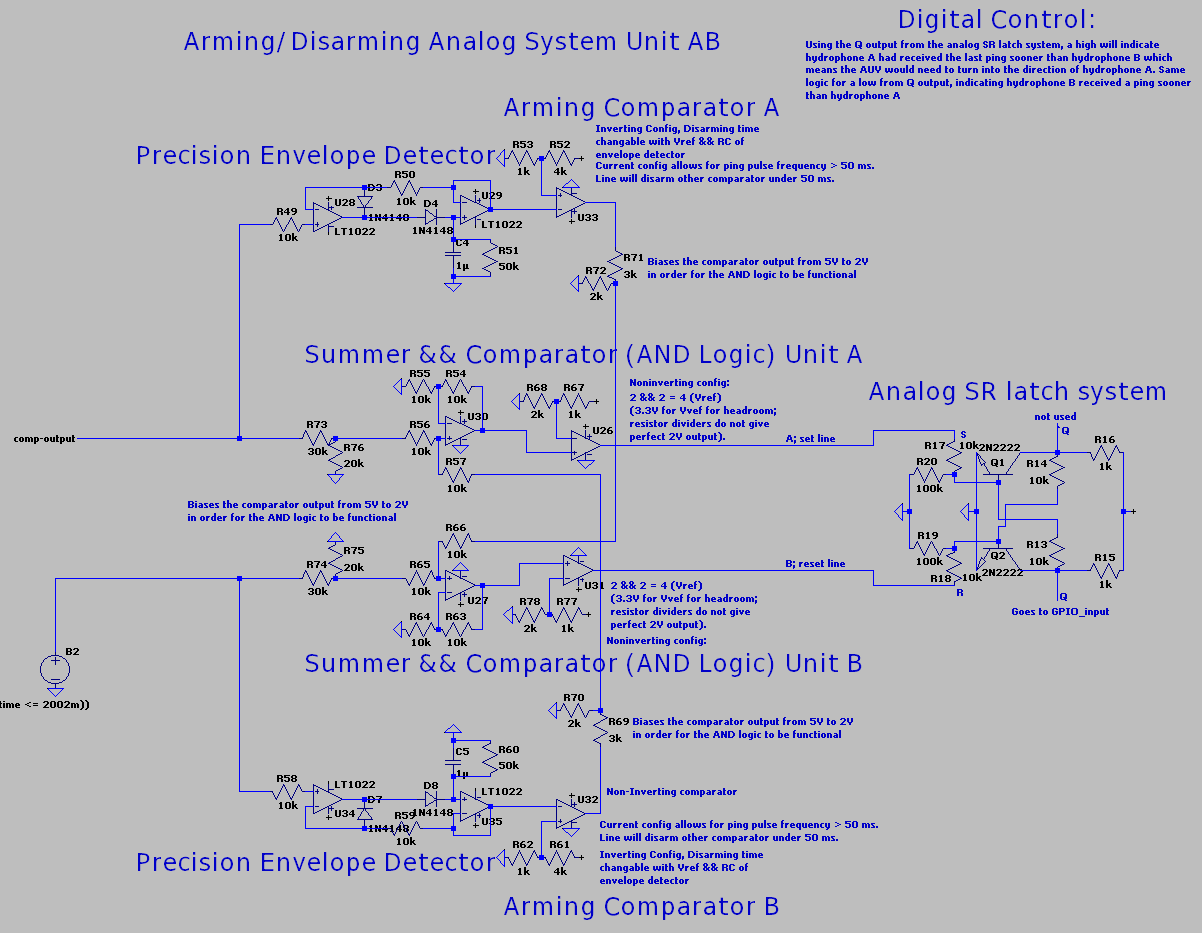
[picture p16: figure]

Block 5 is an optional, but useful last bit of circuitry that allows the PALMS system to locate a pinger using completely analog circuitry! To describe the function:

For example, let's say that unit A had received a digital pulse before unit B. Unit A would have the pulse travel through the “AND logic” which already had its other input high since the inverted comparator on unit B’s side would be still high, and would then proceed to activate the SR latch system, which would stay high unless reset by a pulse from unit B.

However, unit B would have received a pulse very shortly after and would reset the SR latch system. Because of the arming/disarming system, arming comparator A prevents that. The pulse unit A received would move through an envelope detector and hold that signal high for around 50 ms, going into the inverted arming comparator A, which would in turn go low, and disarm unit B’s “AND logic”. 50 ms is perfectly acceptable because the shortest pulse frequency of the pingers is 500 ms, or half a second. The same exact behavior would happen on the other side if unit B had received a pulse before unit A.

While much easier to understand the whole process by manually simulating transients, the following simulation shows multiple signals, with primary importance of the AND logic of unit B being turned off, and the SR latch holding a high, indicating unit A received a response before unit B, with 40 microseconds being the difference of time between unit A and B:

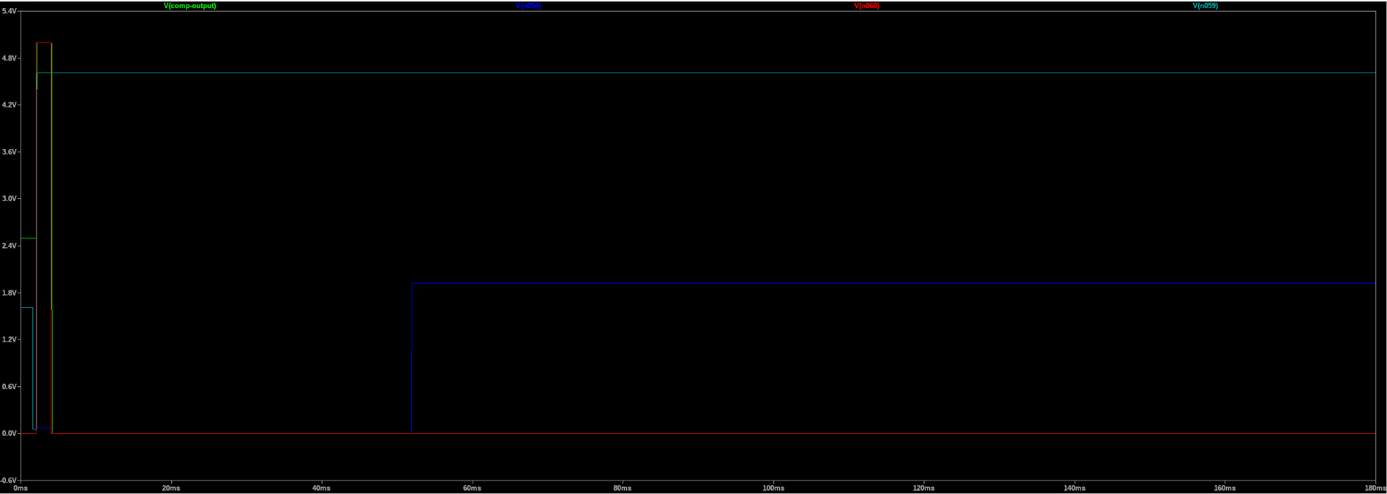
[picture p17: figure]

The circuitry shown throughout this documentation is easier to simply copy/paste, 3 analog processing modules (for 3 hydrophone transducers to compare both horizontal and vertical angle) and 2 TDOA modules (to output high/low to go left/right, and another high/low to go up/down).

This concludes the PALMS System Design documentation. This document is subject to change.
