danenicol/PALMS/PALMS.asc

B1: bv; v = 0.001 * sin(2*pi*40k*time) * ((time >= 2m & time <= 4m) | (time >= 2000m & time <= 2002m))
B2: bv; v = 5 * ((time >= 2.04m & time <= 4.04m) | (time >= 2000.04m & time <= 2002.04m))
C1: cap; 10n
C2: cap; 10n
C3: cap; 1µ
C4: cap; 1µ
C5: cap; 1µ
C7: cap; 10n
C8: cap; 10n
D1: diode; 1N4148
D2: diode; 1N4148
D3: diode; 1N4148
D4: diode; 1N4148
D7: diode; 1N4148
D8: diode; 1N4148
D11: diode; 1N4148
D12: diode; 1N4148
Q1: npn; 2N2222
Q2: npn; 2N2222
R1: res; 10k
R2: res; 10k
R3: res; 10k
R4: res; 1k
R5: res; 50k
R6: res; 1Meg
R7: res; 1Meg
R8: res; 55
R9: res; 390
R10: res; 55
R11: res; 80
R12: res; 1k
R13: res; 10k
R14: res; 10k
R15: res; 1k
R16: res; 1k
R17: res; 10k
R18: res; 10k
R19: res; 100k
R20: res; 100k
R21: res; 105
R22: res; 150; tol=50
R23: res; 500
R24: res; 500
R25: res; 80
R26: res; 105
R27: res; 150
R28: res; 390
R29: res; 1k
R30: res; 10k
R31: res; 10k
R32: res; 10k
R33: res; 8k
R34: res; 5k
R35: res; 5k
R36: res; 5k
R37: res; 10k
R39: res; 5k
R40: res; 10k
R41: res; 8k
R42: res; 10k
R43: res; 10k
R49: res; 10k
R50: res; 10k
R51: res; 50k
R52: res; 4k
R53: res; 1k
R54: res; 10k
R55: res; 10k
R56: res; 10k
R57: res; 10k
R58: res; 10k
R59: res; 10k
R60: res; 50k
R61: res; 4k
R62: res; 1k
R63: res; 10k
R64: res; 10k
R65: res; 10k
R66: res; 10k
R67: res; 1k
R68: res; 2k
R69: res; 3k
R70: res; 2k
R71: res; 3k
R72: res; 2k
R73: res; 30k
R74: res; 30k
R75: res; 20k
R76: res; 20k
R77: res; 1k
R78: res; 2k
R79: res; 500k
R80: res; 1Meg
R83: res; 10k
R84: res; 10k
R85: res; 10k
R86: res; 10k
R87: res; 10k
R134: res; 10k
U1: LT1022
U2: LT1022
U3: LT1022
U4: LT1022
U5: LT1022
U6: ADG1402
U7: ADG1402
U8: ADG1402
U9: ADG1402
U10: ADG1402
U11: ADG1402
U12: ADG1402
U13: ADG1402
U14: LT1022
U17: ADG1402
U18: ADG1402
U19: LT1022
U20: LT1022
U21: ADG1402
U22: LT1022
U23: LT1022
U24: LT1022
U26: UniversalOpAmp2
U27: UniversalOpAmp2
U28: LT1022
U29: LT1022
U30: UniversalOpAmp2
U31: UniversalOpAmp2
U32: UniversalOpAmp2
U33: UniversalOpAmp2
U34: LT1022
U35: LT1022
U37: UniversalOpAmp2
U39: ADG1402
U40: LT1022
U41: LT1022
U50: ADG1402
V1: voltage; 5
V3: voltage; 5
V4: voltage; 5
V5: voltage; 0
V6: voltage; 0
V8: voltage; 0
V9: voltage; 0
V10: voltage; 0
V11: voltage; 0
V12: voltage; 0
V13: voltage; 5
Named nets: -, +, 0, 20, 25, 30, 35, 2s, 1x, 2x, 10x, 20x, bandpass-output, amp-output, rectifier-output, comp-output, 26x, 8x
Rg
Rb
Rf1
Rf2
Cf1
Cf2
Rl
Rin
Rh
Bandpass
Voltage Buffer
R
S
`Q
Q
Inverting Amplifier with analog switch configured amplification
with bandpass output with analog switch configured center frequency selection + voltage buffer
40 kHz
35 kHz
30 kHz
25 kHz
20 kHz
MCU GPIO Ouputs
Sequential Incrementing Control:
.tran 3
Resistance for center frequency:
395 Ohm: 40 kHz
445 Ohm: 35 kHz
525 Ohm: 30 kHz
630 Ohm: 25 kHz
780 Ohm: 20 kHz
Designed by: Dane Nicol
July 24, 2025
Kerwin-Heulsman-Newcomb Biquad State Variable Filter Topology
Gain:
Av = -(Rf / R1)
Rf
R1
Each gate when off will short the connection between the previous resistor
and the next one, allowing precise incrementation of Rf resistors
Precision Full Wave Rectifier
Amplitude-Threshold/Delay Block
The Precision Full Wave Rectifier passes through positive waves with unity gain
and inverts negative waves with unity gain, essentially providing a rectified response
using diode biasing as control.
Envelope Detector holds DC value of 
peak input, with a decay rate of:
V(t) = V_0 * e^(-t / RC)
Where:
V_0 = initial voltage
t = time of discharge
RC = resistor capacitor config
Cascaded inverting amplifiers:
-0.8x * -1x (non-inverting output)
Triggers if >80% of the maximum 
amplitude of the reference is met with
the input pulse from V_in.
Precision Envelope Detector
Arming Comparator A
Inverting Config, Disarming time 
changable with Vref && RC of 
envelope detector
Current config allows for ping pulse frequency > 50 ms. 
Line will disarm other comparator under 50 ms.
Summer && Comparator (AND Logic) Unit A
Precision Envelope Detector
Arming Comparator B
Inverting Config, Disarming time 
changable with Vref && RC of 
envelope detector
Current config allows for ping pulse frequency > 50 ms. 
Line will disarm other comparator under 50 ms.
Summer && Comparator (AND Logic) Unit B
Biases the comparator output from 5V to 2V
in order for the AND logic to be functional
Biases the comparator output from 5V to 2V
in order for the AND logic to be functional
Biases the comparator output from 5V to 2V
in order for the AND logic to be functional
2 && 2 = 4 (Vref)
(3.3V for Vvef for headroom; 
resistor dividers do not give
perfect 2V output).
Noninverting config:
A; set line
B; reset line
Analog SR latch system
Goes to GPIO_input
Noninverting config:
2 && 2 = 4 (Vref)
(3.3V for Vvef for headroom; 
resistor dividers do not give
perfect 2V output).
PALMS
Passive Analog Localization via Multilateration System
Arming/Disarming Analog System Unit AB
Trigger Comparator A
0.5x
1x
2x
Using the Q output from the analog SR latch system, a high will indicate 
hydrophone A had received the last ping sooner than hydrophone B which 
means the AUV would need to turn into the direction of hydrophone A. Same
logic for a low from Q output, indicating hydrophone B received a ping sooner
than hydrophone A
Digital Control:
This is the pulse that is inputted into the 
comparator, which is then compared against 
Envelope detector that holds the peak signal 80%, 
so if this signal is over that, the comparator activates.
Hydrophone Transducer
State Variable Filter
Power Rails
;ac oct 10m 1 1Meg
Frequency  Selection Control
D1
D2
R1
R2
R3
R4
R5
Op_1
Op_2
RC
10x
2nd-order butterworth lowpass
R1
R1
Reference Evelope Detector
-(0.8x)
-(1x)
+(0.8x)
RA
RB
C1
C2
The active lowpass filter does the initial smoothing 
for two inputs into a comparator:
1: Reference decaying envelope
2: Input signal
R1
Rf
R1
Rf
V_ref -->
V_in -->
Manual Pulse Frequency Adjustment
Note: discrepancy between
formula and simulation is 
expected. Peak of evelope
will also be either higher
or lower than input.
+ (0.001 * white(1e6*time)
not used
Non-Inverting comparator
0.5x is default state
always on, higher
amplification works
off incrementation
If an unexpected high value
comes from pinger, it will 
compensate
Voltage>2.8 indicates clipping, meaning 
pinger is unexpectly giving
too high of voltage.
Default
State
Default State
Always on
Frequency
Selection is
Incremental
Default State
Always on
Frequency
Selection is
Incremental
40 kHz
40 kHz
0.01 hydrophone --> bandpass --> ~2.8 V (starts clipping)
0.08 hydrophone --> bandpass --> ~2.5 V
0.05 hydrophone --> bandpass --> ~1.5 V (probable peak up close)
0.03 hydrophone --> bandpass --> ~0.9 V
0.01 hydrophone --> bandpass --> ~0.3 V
5 mV hydrophone --> bandpass --> ~150 mV
1 mV hydrophone --> bandpass --> ~30 mV (probable minimum far away)
Adjust based on what pulse frequency is closer.
20x
0.5x
1x
2x
8x
26x
Amplification Selection Control
Default
State
Manual Amplification Adjustment
1s is default state
always on, higher
decay works
off incrementation
~1 second
~2 seconds
1s
2s
Default
State
Pulse Frequency Selection Control
Voltage Buffer
