danenicol/PALMS/(commit log)

2025-08-15 Create Theory and Calculations of State Variable Filtering
2025-08-15 Rename Theory and Calculations of State Variable Filtering to Theory and Mathematics of State Variable Filtering
2025-08-15 Create Circuitry Overview and Signal Flow
2025-08-15 Create State Variable Filter Calculations.md
2025-08-15 Rename Circuitry Overview and Signal Flow to Circuitry Overview and Test Simulation.md
2025-08-16 Update Circuitry Overview and Test Simulation.md
2026-02-08 Update Circuitry Overview with new images and section
    Added images and section for bandpass/amplification stage.
2026-02-09 Enhance documentation on bandpass/amplification stage
    Added explanation for voltage buffer and bandpass filter.
2026-03-02 Add PCB Design and Application in UAV sections
2026-08-25 Update PCB design iterations in README
    Updated PCB design iterations and added images for Iteration #2.
